koekie/iaq_board/kicad/my_libs/3dmodels/SCD30.step

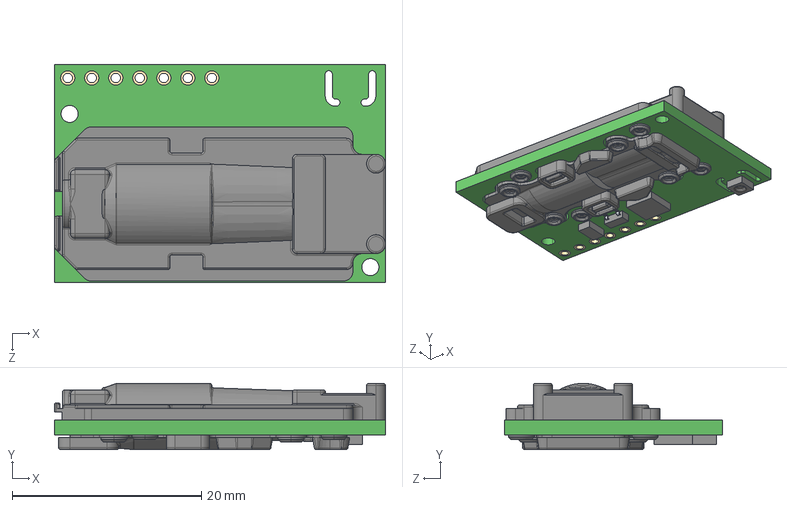
[picture p1: CAD file, 2023-02-05]
kicad/my_libs/3dmodels/SCD30.step
35.0 x 7.00 x 23.0 mm
