koekie/iaq_board/kicad/iaq_device/iaq_device.kicad_pcb

## KiCad design kicad/iaq_device/iaq_device.kicad_pcb (2023-08-28)

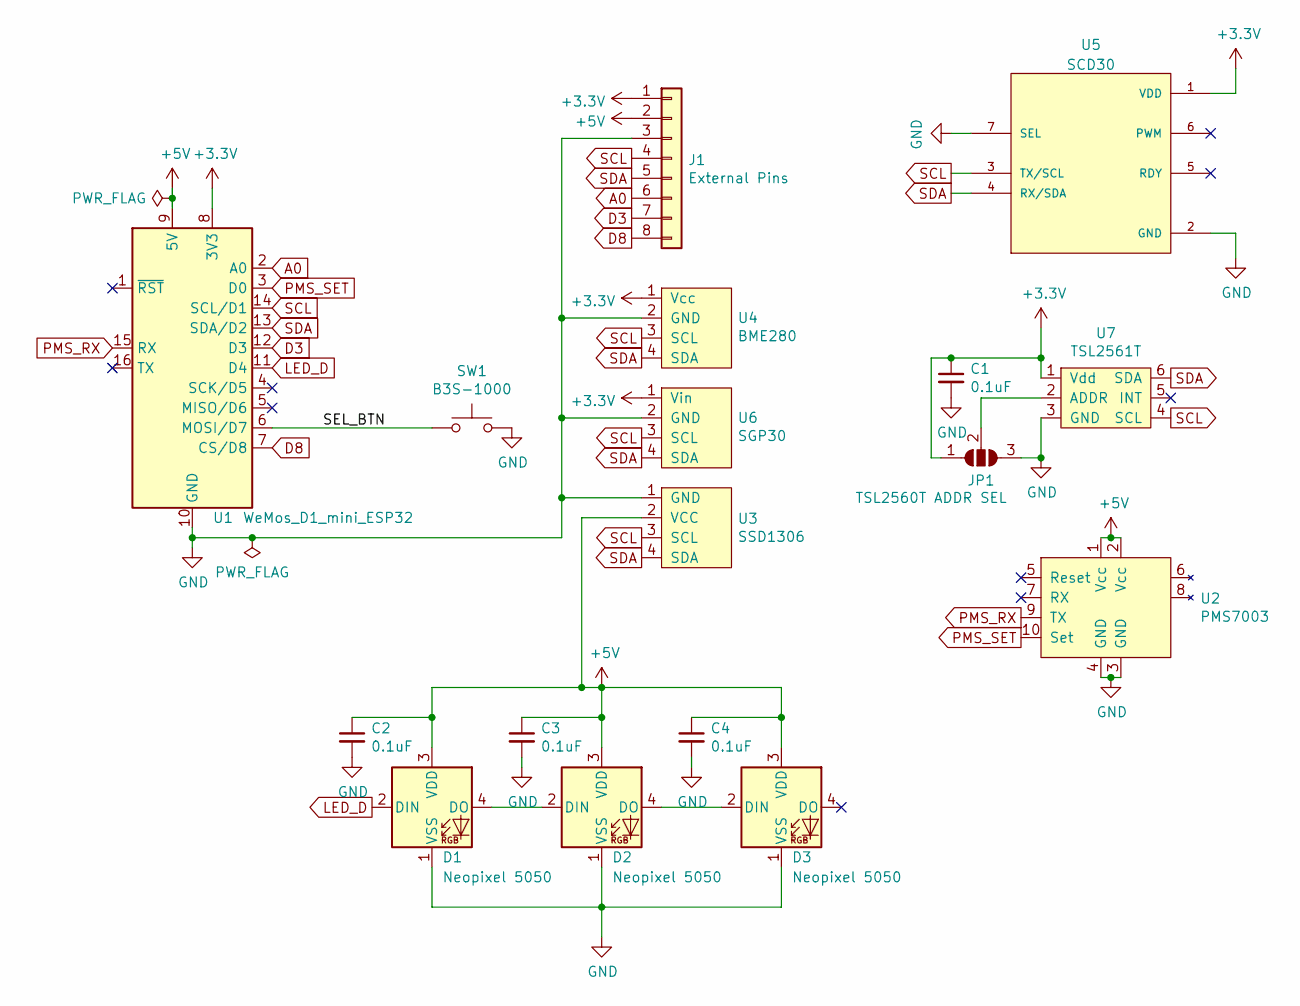
[picture p2: schematic iaq_device.kicad_sch, Wemos D1 Mini Internal Air Quality Board]

Parts:
C1, C2, C3, C4: 0.1uF; C_0805_2012Metric
D1, D2, D3: Neopixel 5050; LED_Inolux_IN-PI554FCH_PLCC4_5.0x5.0mm_P3.2mm
J1: External Pins; PinSocket_1x08_P2.54mm_Vertical_SMD_Pin1Left
JP1: TSL2560T ADDR SEL; SolderJumper-3_P1.3mm_Open_RoundedPad1.0x1.5mm_NumberLabels
SW1: B3S-1000; SW_SPST_B3S-1000
U1: WeMos_D1_mini_ESP32; WEMOS_D1_surface
U2: PMS7003
U3: SSD1306
U4: BME280; BME280_breakout_6pin
U5: SCD30; PARTREV D1
U6: SGP30; SGP30_breakout_4pin
U7: TSL2561T

Connections:
+3.3V: C1.1, J1.1, JP1.1 (A), U1.8 (3V3), U4.1 (Vcc), U5.1 (VDD), U6.1 (Vin), U7.1 (Vdd)
+5V: C2.1, C3.1, C4.1, D1.3 (VDD), D2.3 (VDD), D3.3 (VDD), J1.2, U1.9 (5V), U2.1 (Vcc), U2.2 (Vcc), U3.2 (VCC)
/SEL_BTN: SW1.1, U1.6 (MOSI/D7)
A0: J1.6, U1.2 (A0)
D3: J1.7, U1.12 (D3)
D8: J1.8, U1.7 (CS/D8)
GND: C1.2, C2.2, C3.2, C4.2, D1.1 (VSS), D2.1 (VSS), D3.1 (VSS), J1.3, JP1.3 (B), SW1.2, U1.10 (GND), U2.3 (GND), U2.4 (GND), U3.1 (GND), U4.2 (GND), U5.2 (GND), U5.7 (SEL), U6.2 (GND), U7.3 (GND)
LED_D: D1.2 (DIN), U1.11 (D4)
unnamed: D1.4 (DO), D2.2 (DIN)
unnamed: D2.4 (DO), D3.2 (DIN)
unnamed: JP1.2 (C), U7.2 (ADDR)
PMS_RX: U1.15 (RX), U2.9 (TX)
PMS_SET: U1.3 (D0), U2.10 (Set)
SCL: J1.4, U1.14 (SCL/D1), U3.3 (SCL), U4.3 (SCL), U5.3 (TX/SCL), U6.3 (SCL), U7.4 (SCL)
SDA: J1.5, U1.13 (SDA/D2), U3.4 (SDA), U4.4 (SDA), U5.4 (RX/SDA), U6.4 (SDA), U7.6 (SDA)

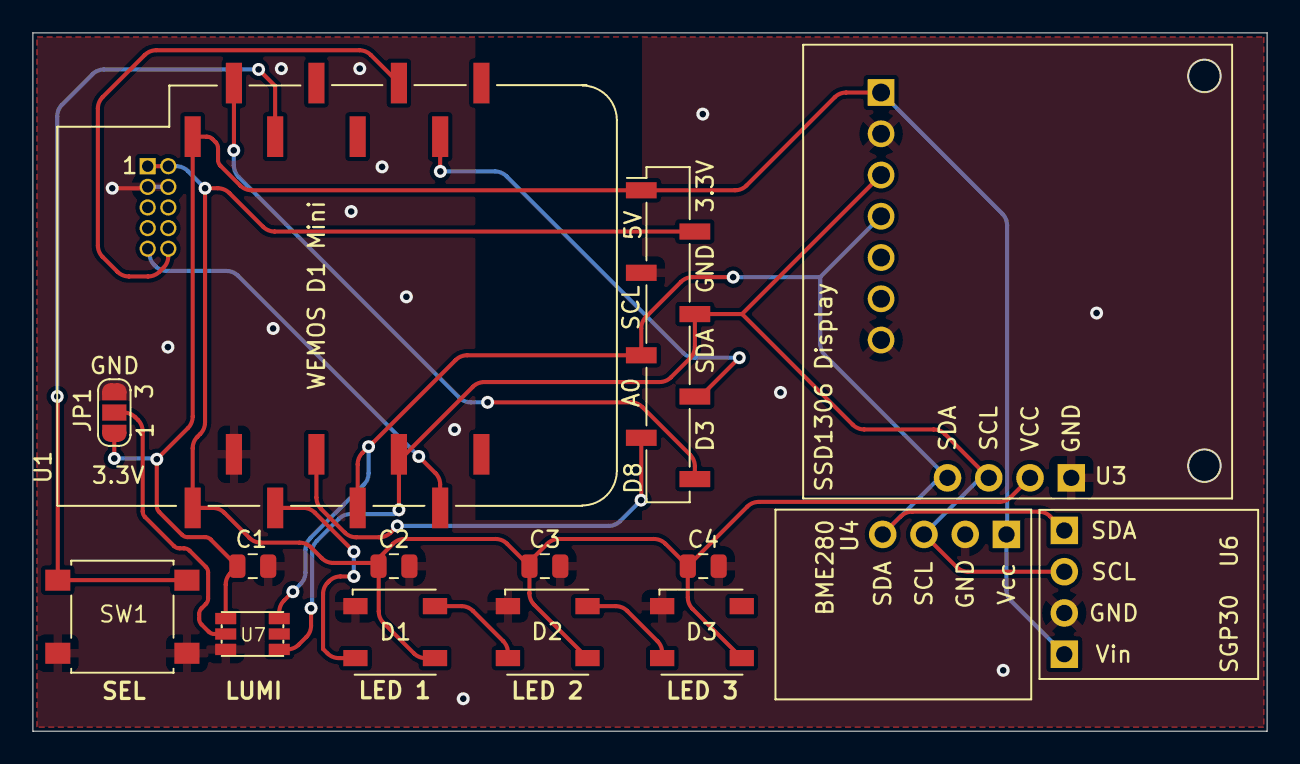
[picture p3: board iaq_device.kicad_pcb from above]

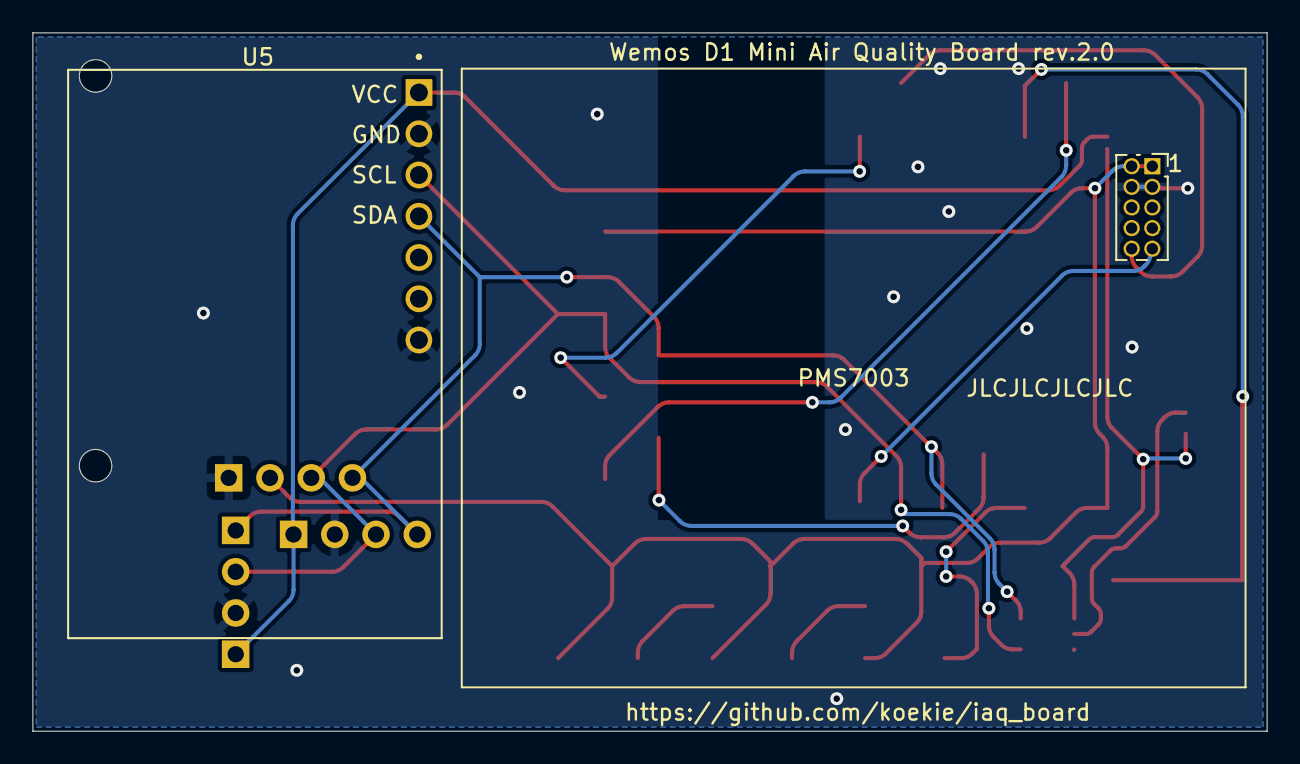
[picture p4: board iaq_device.kicad_pcb from below]

Board: 2 copper layers, 76.0 x 43.0 mm, 17 parts (2 on the bottom side), 15 nets.
