koekie/iaq_board/(commit log)

2023-02-05 fix stuff for kicad and adds scd30 co2 sensor symbol, footprint and 3d model
    [SCD30.step, iaq_device.kicad_pcb, iaq_device.kicad_sch]
2023-03-08 lots of changes
    [iaq_device.kicad_pcb, iaq_device.kicad_sch]
2023-03-23 changed co2 sensor to scd30 and rerouted the board
    [iaq_device-B_Cu.gbl, iaq_device-B_Cu.gbr, iaq_device-B_Mask.gbr, iaq_device-B_Mask.gbs, iaq_device-B_Paste.gbp, iaq_device-B_SilkS.gbr, iaq_device-B_Silkscreen.gbo, iaq_device-Edge_Cuts.gbr]
2023-08-28 some small changes to board and updates to kicad 7
    [iaq_device-B_Cu.gbl, iaq_device-B_Mask.gbs, iaq_device-B_Paste.gbp, iaq_device-B_Silkscreen.gbo, iaq_device-Edge_Cuts.gm1, iaq_device-F_Cu.gtl, iaq_device-F_Mask.gts, iaq_device-F_Paste.gtp]
